ThePyProgrammer/mBotProject/notes/formulae/Rotation.md

For rotation, we manually measure.

Period for 45 Rotations at MOTOR_SPEED = 200: **70.53 seconds**
Average Period: $\frac{70.53}{45} = 1.56733\text{ s}$
