ThePyProgrammer/mBotProject/diagrams/img/Slide4.PNG

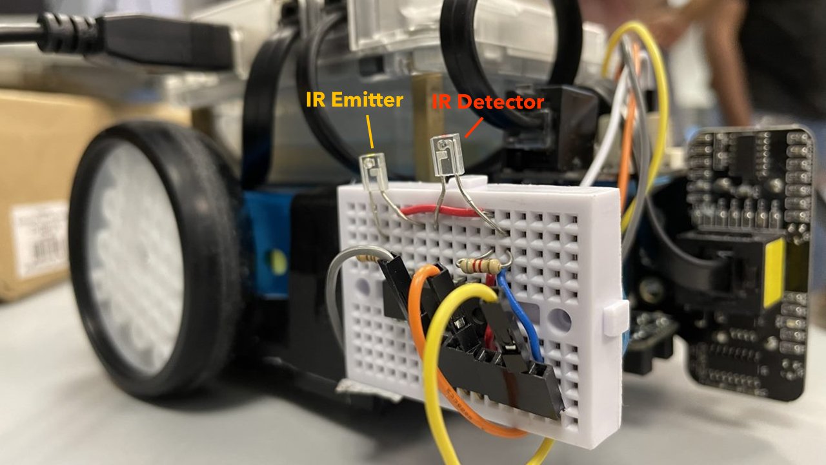
diagrams/img/Slide4.PNG
