ThePyProgrammer/mBotProject/diagrams/img/Slide5.PNG

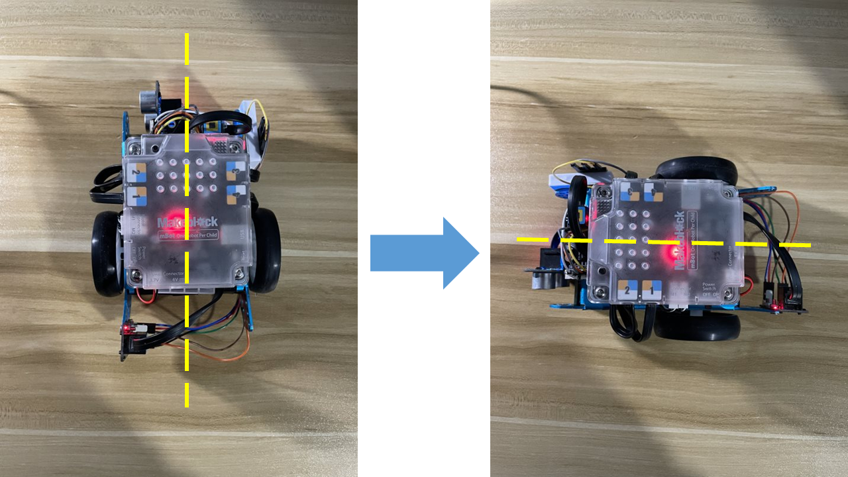
diagrams/img/Slide5.PNG
