ThePyProgrammer/mBotProject/diagrams/img/Slide6.PNG

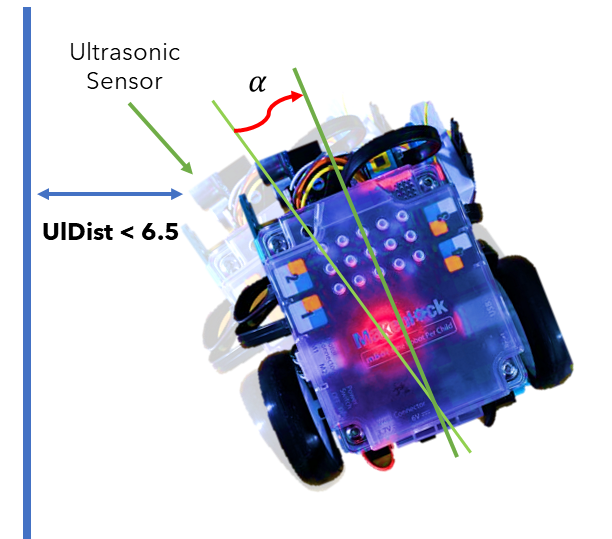
diagrams/img/Slide6.PNG
