ThePyProgrammer/mBotProject/diagrams/img/Slide7.PNG

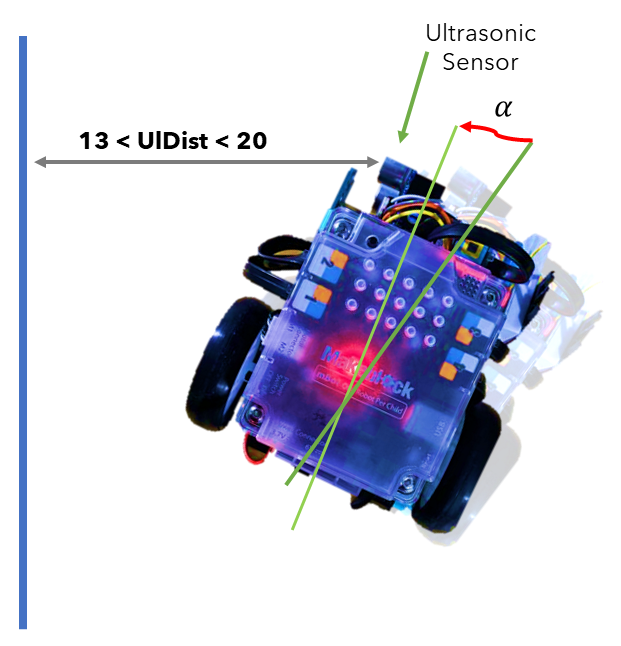
diagrams/img/Slide7.PNG
