ThePyProgrammer/mBotProject/notes/materials/Installing Arduino IDE, mBot Library & Driver.pdf

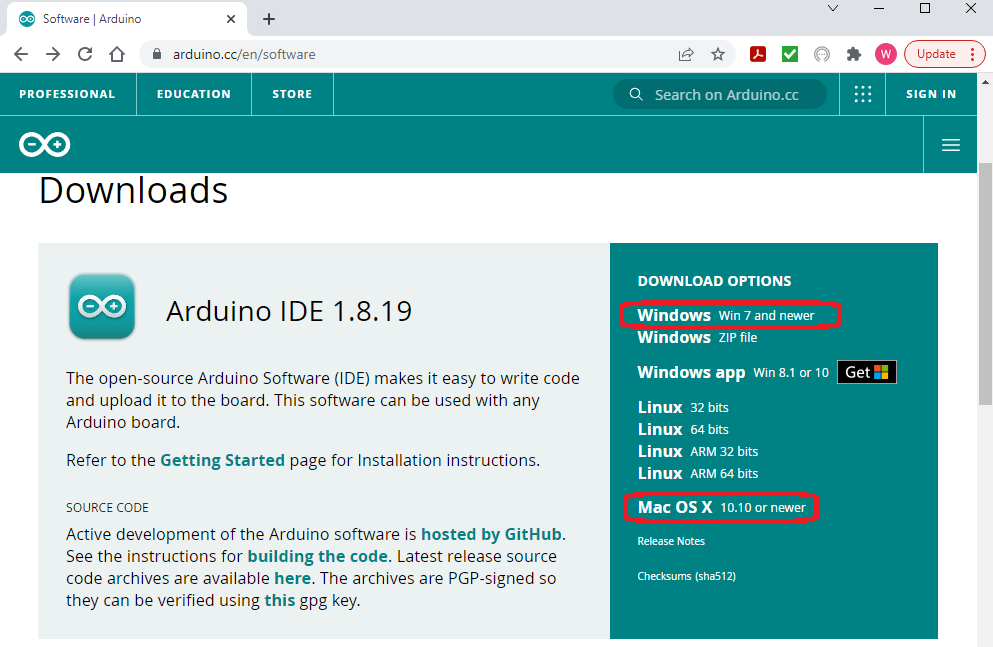
[picture p28: figure]
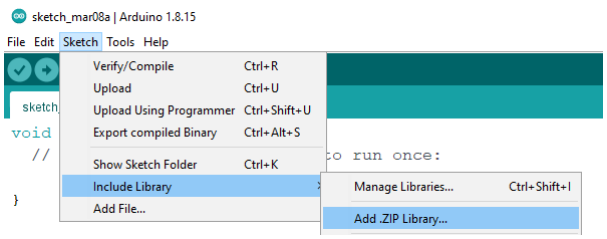
[picture p29: figure]

© Dept of Electrical & Computer Engineering, National University of Singapore | Page 1

## Instructions for Installing Arduino IDE, mBot Library & Driver

1. The Arduino Integrated Development Environment (IDE) is the key software used for programming the mBot. To download it, go to https://www.arduino.cc/en/software.
- For Windows operating systems, you may choose “Windows – Win 7 and newer”.
- For Mac OS X, you may choose “Mac OS X – 10.10 or newer”.
2. After downloading the Arduino IDE’s installation file, install it into your computer.
3. Next, we will download mBot’s library. Click on the following link: https://codeload.github.com/Makeblock-official/Makeblock-Libraries/zip/master
(Take note of where you’d saved the file. There is no need to unzip this file.)
4. We will now add mBot’s library into your Arduino IDE.
- In the Arduino IDE, choose from the menu: "Sketch” -> “Include Library” -> “Add .ZIP Library”, then select the .zip file you’d downloaded in Step 3.

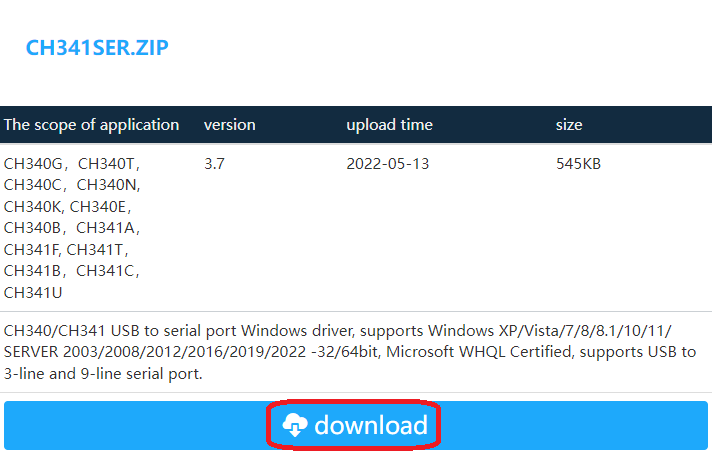
[picture p30: figure]
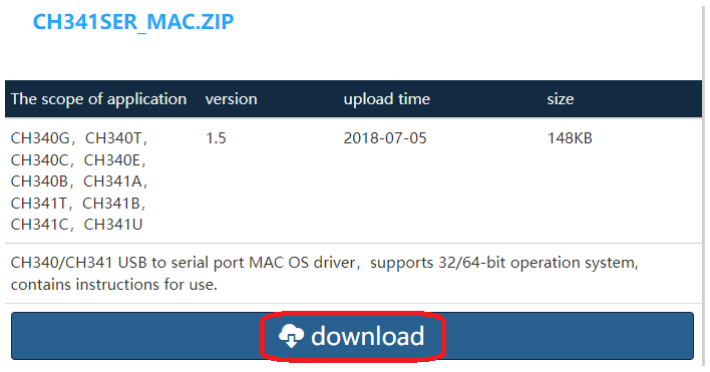
[picture p31: figure]

© Dept of Electrical & Computer Engineering, National University of Singapore | Page 2
5. Now, we need to install the USB driver for the mBot.
- For Windows operating system, download the driver from http://www.wch-ic.com/downloads/CH341SER_ZIP.html
- Unzip the “.zip” file.
- To install the driver, run the “SETUP.EXE” file inside the newly created folder.
- For Mac OS X, download the driver from http://www.wch-ic.com/downloads/CH341SER_MAC_ZIP.html
- Unzip the “.zip” file.
- Follow the instructions given in “ReadMe.pdf”.
