ThePyProgrammer/mBotProject/(commit log)

2022-10-12 switched to using arduino ide
2022-11-10 Finality is not among us
    [red_excitation.csv]
